noahseanui42/Matlab/Enclosure/preview.png

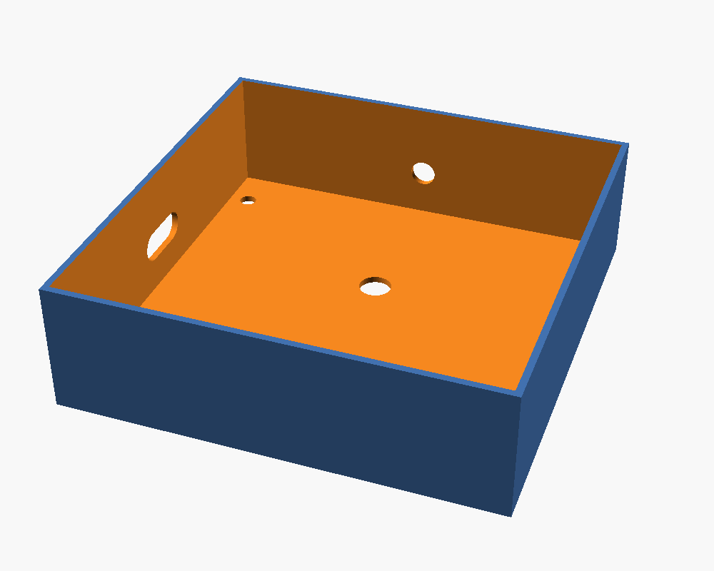
Enclosure/preview.png
