noahseanui42/Matlab/Enclosure/enclosure_lid.step

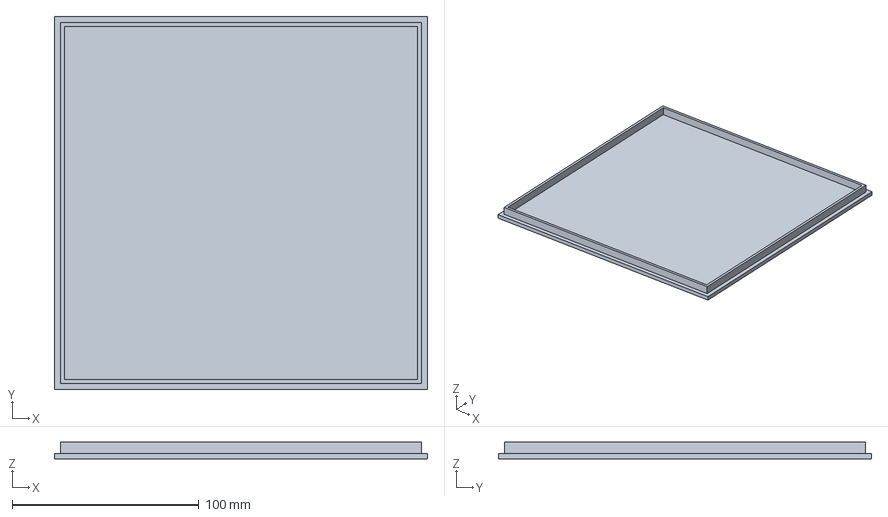
[picture p2: CAD file, 2026-10-01]
Enclosure/enclosure_lid.step
200.0 x 200.0 x 9.00 mm
