noahseanui42/Matlab/Enclosure/enclosure_box.step

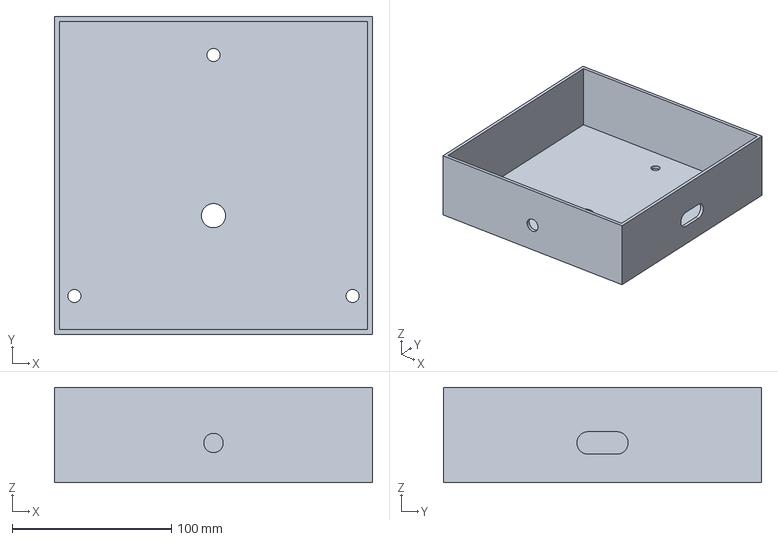
[picture p3: CAD file, 2026-10-01]
Enclosure/enclosure_box.step
200.0 x 200.0 x 60.0 mm
