noahseanui42/Matlab/(list of files, cad)

Other CAD files:
Enclosure/enclosure_box.stl
Enclosure/enclosure_lid.stl
