noahseanui42/Matlab/(commit log)

2026-09-27 Add servo firmware + patched GUI for the delta robot (replaces stepper firmware)
    Ports grzesiek2201/Delta-Robot (GPL-3.0 @ 48a8038) to drive 3 hobby servos
    on an Arduino UNO R4 Minima instead of steppers, keeping the GUI's serial
    protocol byte-for-byte compatible. kinematics/protocol/motion are Arduino-
    header-free and host-testable; delta_servo.ino is glue only.
    - kinematics.cpp: ported IK + zHome, with explicit discriminant/singularity
    guards instead of NaN comparisons, per HANDOFF §6.2
    - protocol.cpp: byte-fed frame parser/dispatcher for the <mode><json><#>
    wire format, using vendored ArduinoJson v7
    - motion.cpp: planner + program runner state machine (smoothstep profiles,
    pending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
    [VerticesCoordinates.py, calculateworkarea.py, config.h, delta_servo.ino, deltagui.py, deltarobot.py, gyro data.py]
2026-09-27 Fix invisible label text on macOS Dark Mode in deltagui.py
    tk widgets that set bg="White" without an explicit fg inherit the
    system text colour, which resolves to white in Dark Mode -- making the
    connection status, position, and angle readout labels invisible
    (white text on white background) even though the GUI was working
    correctly underneath. Force black-on-white defaults via option_add so
    this doesn't depend on the user's system appearance setting.
    [deltagui.py]
2026-09-27 Widen deltagui.py's default window so the layout isn't clipped
    1100x700 was too small for the control panel + the 600x600 3D plot +
    padding (needs ~1200px wide). macOS's native "Enter Full Screen" also
    doesn't resize classic Tk windows, so a cramped default stayed cramped
    even fullscreened -- found during hardware bring-up. Sized to fit the
    layout up front instead.
    [deltagui.py]
2026-09-27 Size deltagui.py's window to fit the actual screen it runs on
    A larger fixed geometry (1500x850) just clipped against smaller
    screens instead of the layout's own content. Query winfo_screenwidth/
    height and cap the window to fit, anchored at the screen's top-left
    corner so a window taller/wider than the visible screen doesn't push
    its own title bar or top controls off-screen. Also explicitly enables
    resizing in case that's related to "Zoom" not responding on macOS.
    [deltagui.py]
2026-09-27 Move Program/Available COMs into the File menu (macOS menu bar bug)
    On macOS's native menu bar, only cascade (dropdown) menus render --
    a bare top-level tk.Menu.add_command() is silently dropped. "Program"
    and "Available COMs" were both added directly to the menubar, so
    neither was ever visible or clickable on macOS (only File/Plots, both
    cascades, ever showed up). Moved both into the File menu, where
    add_command works fine since it's inside an actual dropdown.
    [deltagui.py]
2026-09-27 Fix Open/Save/Save as missing in the Program Creator popup on macOS
    Same bug as the main window's Program/Available COMs menu items: bare
    top-level tk.Menu.add_command() calls are invisible on macOS's native
    menu bar (only cascades render), and this Toplevel's menu had the same
    pattern for Open/Save/Save as. Wrapped them in a "File" cascade.
    [deltagui.py]
2026-09-27 Apply real calibration data measured 2026-09-26
    Per-arm centre_us/us_per_deg/dir/min_deg/max_deg from the user's
    host-side calibration tool, one arm at a time with the rest of the
    linkage flat -- replaces the TODO(calibrate) placeholders in
    config.h/robot_config.py. Also fills in the now-known GUI host
    (macOS, port, DTR).
    The real limits are much tighter than the ±(-30,80) placeholder: the
    on-axis reachable envelope shrinks to roughly z=-561..-692mm, well
    short of the project's -450..-750mm scan target. Flagged prominently
    in the README pending a full-assembly recheck (the single-arm
    measurement may not hold once all three arms are linked together).
    Test fixtures updated to match:
    - test_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
    [config.h, motion_test_runner.cpp, robot_config.py, test_ik_parity.py, test_kinematics.py]
2026-09-27 Correct angle limits with full 3-arm assembly measurement
    The single-arm calibration pass (previous commit) turned out to be
    falsely tight: driving one arm while the other two are slack lets the
    effector plate sag/tilt out of level, causing an early collision with
    the unsupported plate that doesn't happen in real coordinated
    operation. Rechecked with all three servos enabled and jogged
    together (plate held level throughout): the real safe range is
    -20/70 deg on all three arms.
    This closes most of the gap to the project's target scan range: the
    on-axis reachable envelope grows from roughly -561..-692mm to
    -550..-793mm, covering the entire deep half of -450..-750mm and then
    some (still ~100mm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
    [config.h, motion_test_runner.cpp, robot_config.py, test_ik_parity.py, test_kinematics.py]
2026-09-27 Set ELBOW_JOINT_WIDTH to the confirmed rod spacing (35mm)
    Real measurement of the parallelogram rod spacing (plot-only cosmetic
    value), replacing the 45mm placeholder.
2026-10-01 Add printable electronics enclosure for the top board
    200x200x60 mm PLA box with friction-fit lid. Floor holes follow the
    base-plate sketch: three 8 mm screw holes on a 175 mm equilateral
    triangle plus a 15 mm centre wire hole. 12 mm power hole on the front
    wall and a 32x14 mm slot on the right wall for the two PC cables.
    Claude-Session: https://claude.ai/code/session_01R32Q8x8msRyey9hK833VnX
    [enclosure.scad, enclosure_box.stl, enclosure_lid.stl]
2026-10-01 Add STEP export of the enclosure for SolidWorks
    CadQuery script mirrors enclosure.scad and writes solid-body STEP files
    for the box and lid, which open directly in SolidWorks.
    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
    [enclosure_box.step, enclosure_lid.step]
